vukit/kardtest/schematic/kardtest.pdf

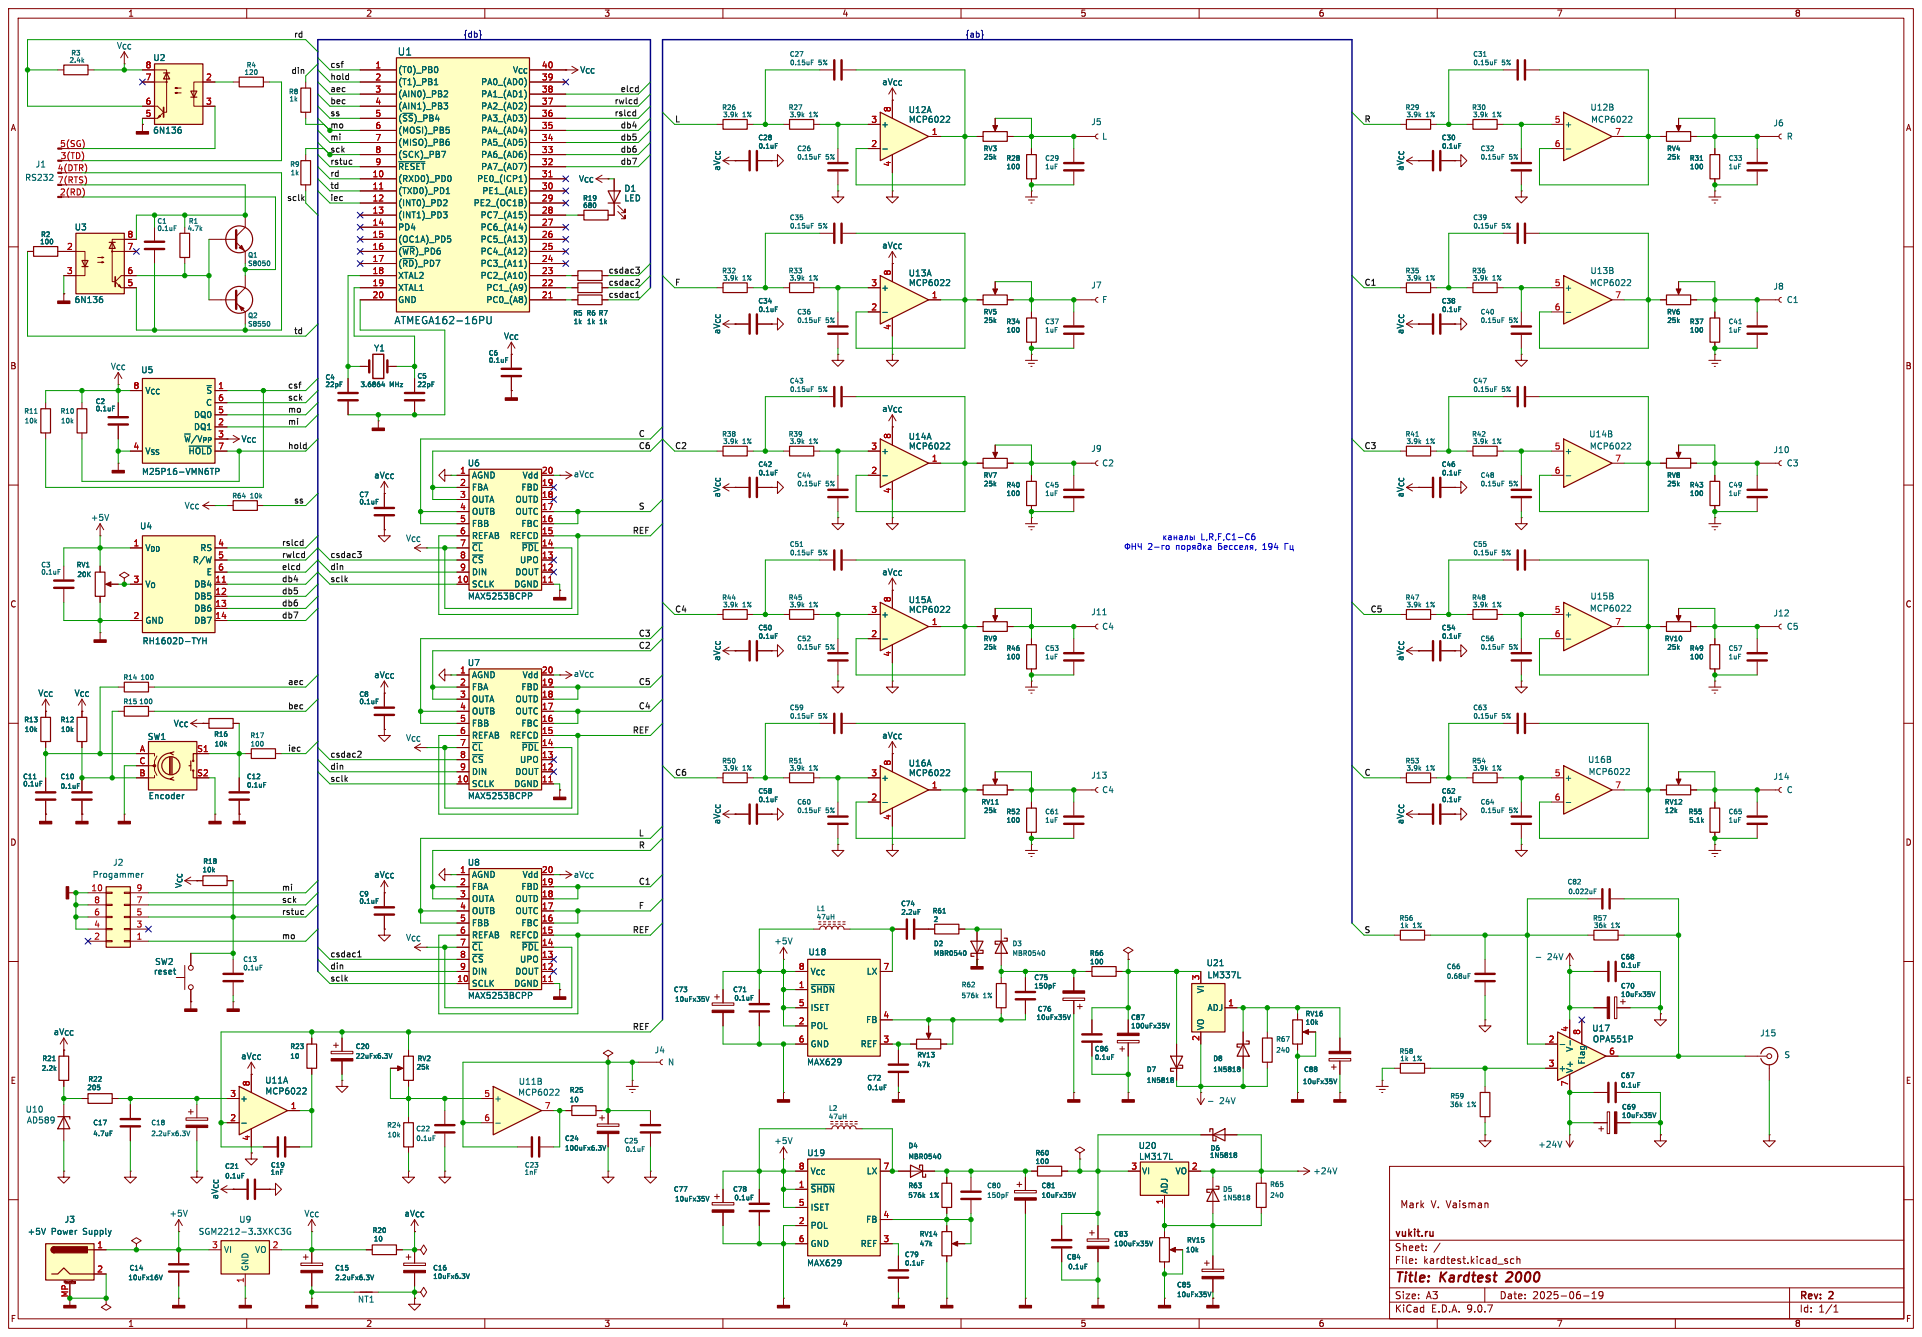
[picture p1: page 1]

mo mi csf bec hold

6 DQ0 5 DQ1 2 ~{W}/V_{PP} 3 ~{HOLD}7 V_{CC} 8 V_{SS} 4 U5M25P16-VMN6TP

6 DQ0 5 DQ1 2 ~{W}/V_{PP} 3 ~{HOLD}7 V_{CC} 8 V_{SS} 4 C2

csf hold mi sck elcdmo
