vukit/kardtest/schematic/kardtest.kicad_sch

## KiCad design schematic/kardtest.kicad_sch (2026-04-05)

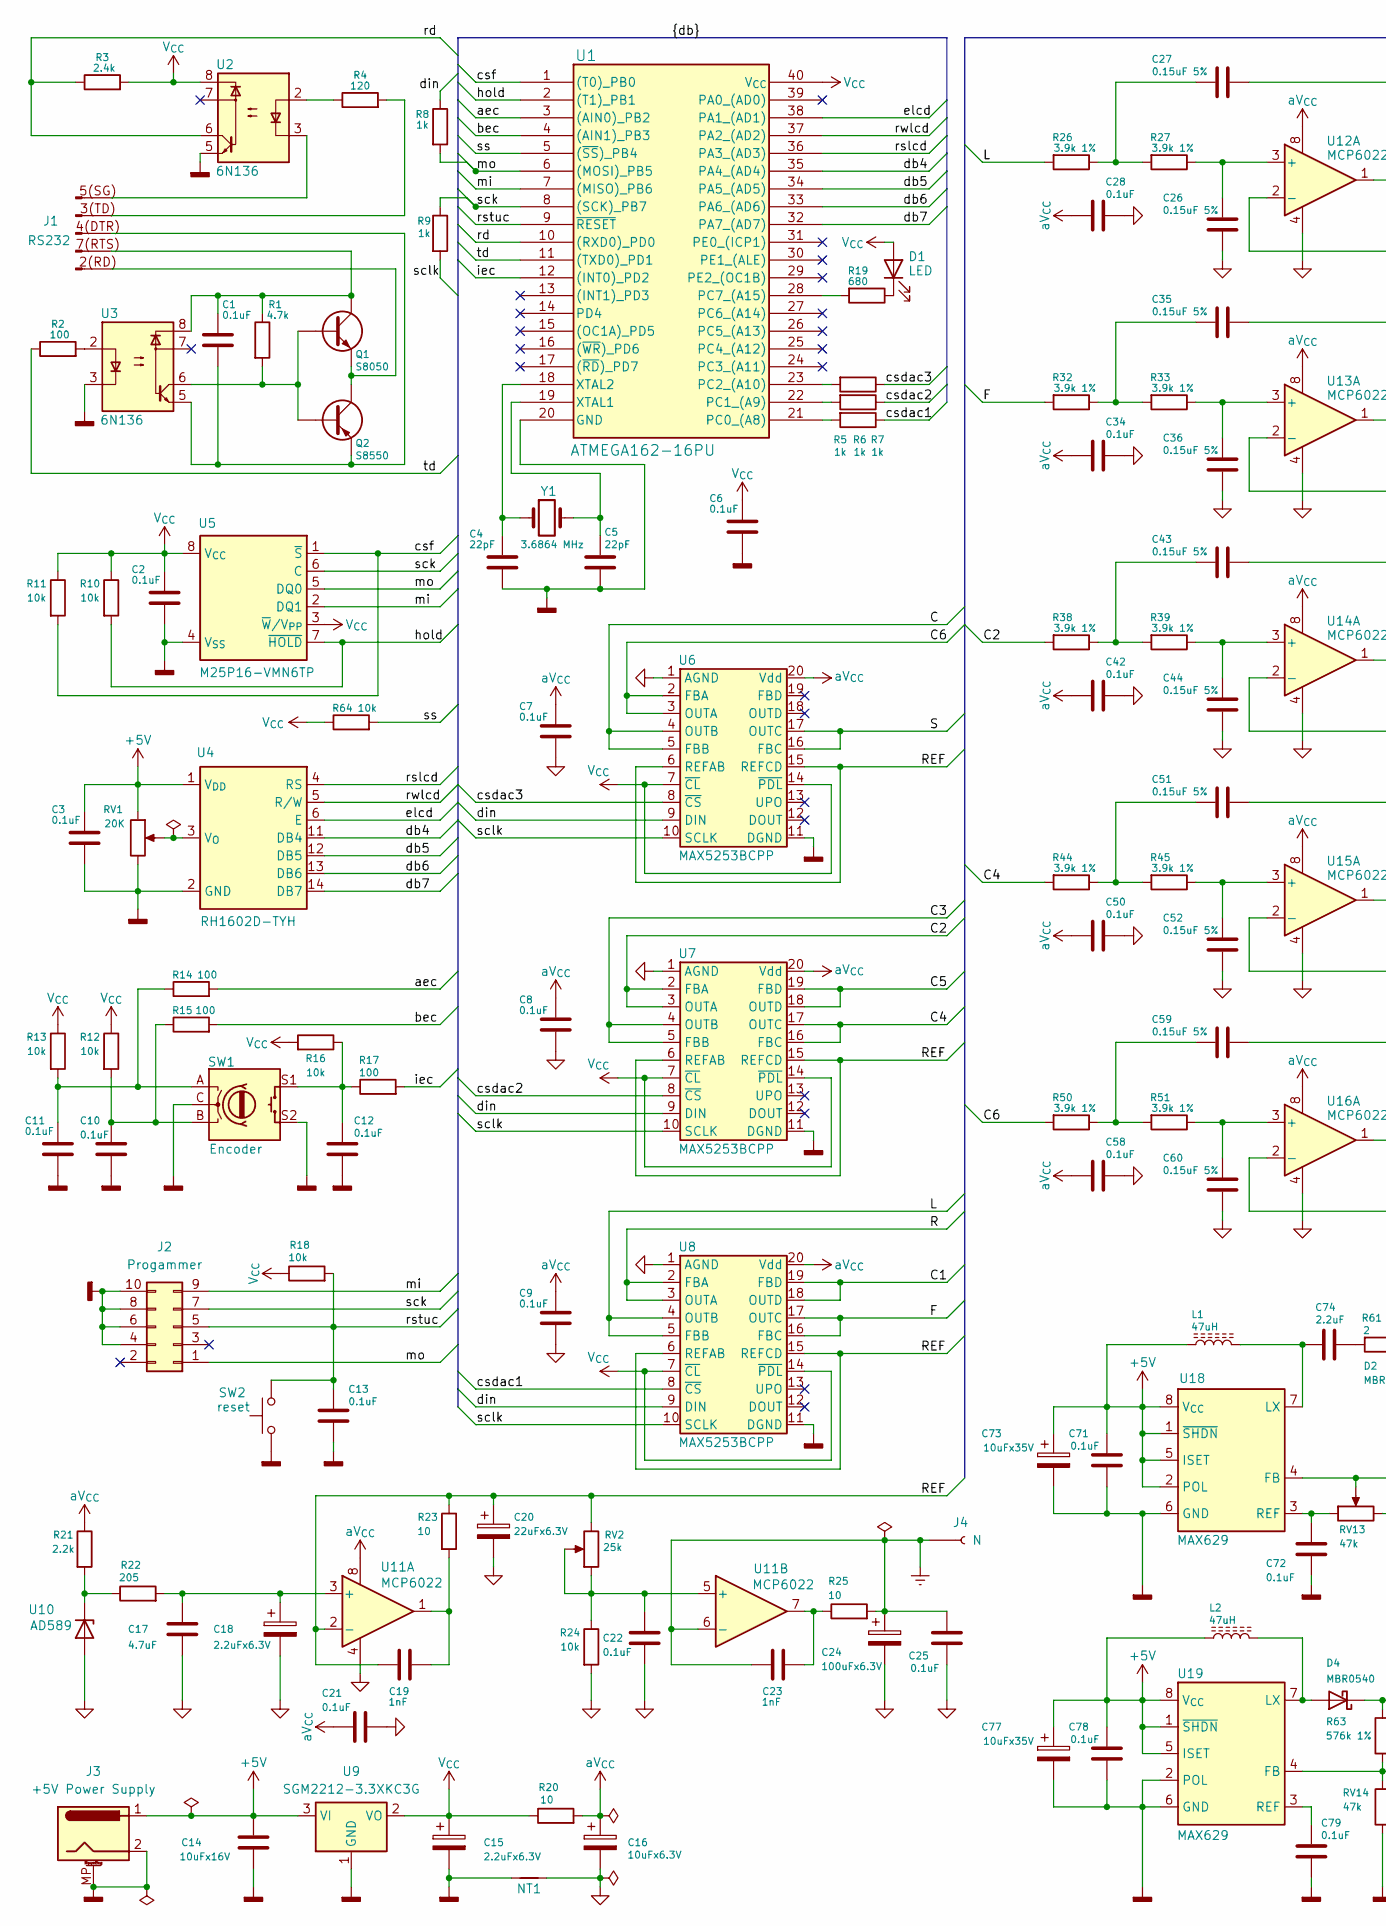
[picture p2: schematic kardtest.kicad_sch, part in row 1, column 1]

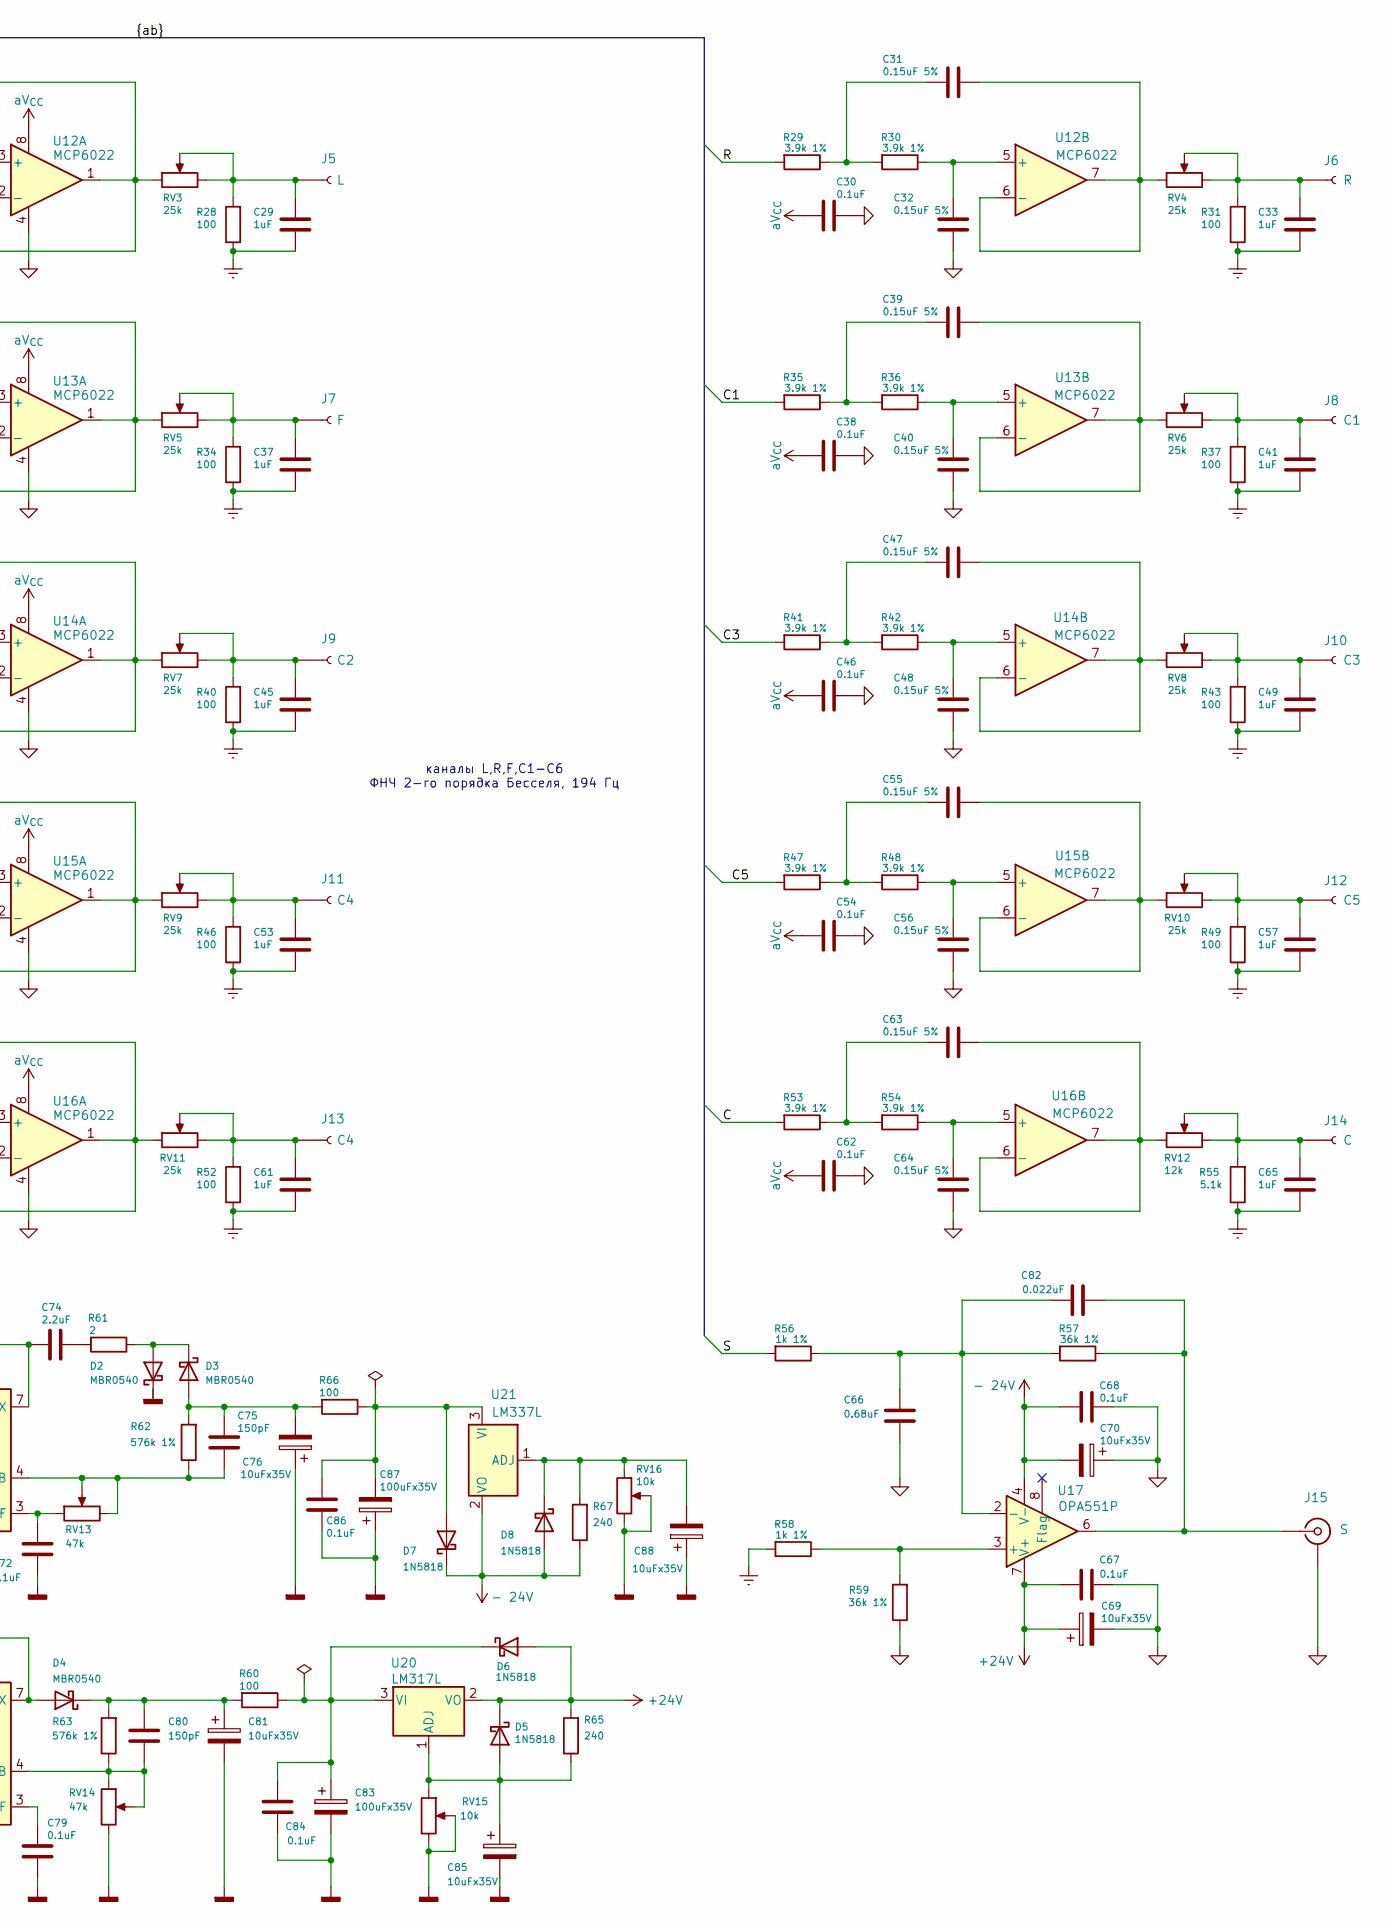
[picture p3: schematic kardtest.kicad_sch, part in row 1, column 2]

Parts:
C1, C2, C3, C6, C7, C8, C9, C10, C11, C12, C13, C21, C22, C25, C28, C30, C34, C38, C42, C46, C50, C54, C58, C62, C67, C68, C71, C72, C78, C79, C84, C86: 0.1uF
C4, C5: 22pF
C14: 10uFx16V
C15, C18: 2.2uFx6.3V
C16: 10uFx6.3V
C17: 4.7uF
C19, C23: 1nF
C20: 22uFx6.3V
C24: 100uFx6.3V
C26, C27, C31, C32, C35, C36, C39, C40, C43, C44, C47, C48, C51, C52, C55, C56, C59, C60, C63, C64: 0.15uF 5%
C29, C33, C37, C41, C45, C49, C53, C57, C61, C65: 1uF
C66: 0.68uF
C69, C70, C73, C76, C77, C81, C85, C88: 10uFx35V
C74: 2.2uF
C75, C80: 150pF
C82: 0.022uF
C83, C87: 100uFx35V
D1: LED
D2, D3, D4: MBR0540; D_SOD-123
D5, D6, D7, D8: 1N5818; D_DO-41_SOD81_P10.16mm_Horizontal
J1: RS232
J2: Progammer
J3: +5V Power Supply
J4: N
J5: L
J6: R
J7: F
J8: C1
J9: C2
J10: C3
J11, J13: C4
J12: C5
J14: C
J15: S
L1, L2: 47uH
NT1: NetTie_2
Q1: S8050; TO-92_Inline
Q2: S8550; TO-92_Inline
R1: 4.7k
R2, R14, R15, R17, R28, R31, R34, R37, R40, R43, R46, R49, R52, R60, R66: 100
R3: 2.4k
R4: 120
R5, R6, R7, R8, R9: 1k
R10, R11, R12, R13, R16, R18, R24, R64: 10k
R19: 680
R20, R23, R25: 10
R21: 2.2k
R22: 205
R26, R27, R29, R30, R32, R33, R35, R36, R38, R39, R41, R42, R44, R45, R47, R48, R50, R51, R53, R54: 3.9k 1%
R55: 5.1k
R56, R58: 1k 1%
R57, R59: 36k 1%
R61: 2
R62, R63: 576k 1%
R65, R67: 240
RV1: 20K
RV2, RV3, RV4, RV5, RV6, RV7, RV8, RV9, RV10, RV11: 25k
RV12: 12k
RV13, RV14: 47k
RV15, RV16: 10k
SW1: Encoder
SW2: reset
U1: ATMEGA162-16PU; DIP-40_W15.24mm
U2, U3: 6N136; DIP-8_W7.62mm
U4: RH1602D-TYH
U5: M25P16-VMN6TP
U6, U7, U8: MAX5253BCPP; DIP-20_W7.62mm
U9: SGM2212-3.3XKC3G; SOT-223-3_TabPin2
U10: AD589
U11, U12, U13, U14, U15, U16: MCP6022
U17: OPA551P; DIP-8_W7.62mm
U18, U19: MAX629
U20: LM317L; TO-92_Inline
U21: LM337L; TO-92_Inline
Y1: 3.6864 MHz

Connections:
+5V: C3.1, C14.1, C71.1, C73.1, C77.1, C78.1, J3.1, L1.1, L2.1, RV1.1, U4.1 (V_{DD}), U9.3 (VI), U18.1 (~SHDN), U18.2 (POL), U18.5 (ISET), U18.8 (V_{CC}), U19.1 (~SHDN), U19.5 (ISET), U19.8 (V_{CC})
+24V: C67.1, C69.1, D5.1 (K), D6.2 (A), R65.2, U17.7 (V+), U20.2 (VO)
- 24V: C68.1, C70.2, D7.1 (K), D8.2 (A), R67.1, U17.4 (V-), U21.2 (VO)
C: R53.2, U6.4 (OUTB), U6.5 (FBB)
C1: R35.2, U8.18 (OUTD), U8.19 (FBD)
C2: R38.2, U7.2 (FBA), U7.3 (OUTA)
C3: R41.2, U7.4 (OUTB), U7.5 (FBB)
C4: R44.2, U7.16 (FBC), U7.17 (OUTC)
C5: R47.2, U7.18 (OUTD), U7.19 (FBD)
C6: R50.2, U6.2 (FBA), U6.3 (OUTA)
F: R32.2, U8.16 (FBC), U8.17 (OUTC)
GNDA: C7.2, C8.2, C9.2, C16.2, C17.2, C18.2, C20.2, C21.1, C22.2, C24.2, C25.2, C26.2, C28.2, C30.2, C32.2, C34.2, C36.2, C38.2, C40.2, C42.2, C44.2, C46.2, C48.2, C50.2, C52.2, C54.2, C56.2, C58.2, C60.2, C62.2, C64.2, C66.2, C67.2, C68.2, C69.2, C70.1, J15.2 (Ext), NT1.2, R24.2, R59.1, U6.1 (AGND), U7.1 (AGND), U8.1 (AGND), U10.2 (A), U11.4 (V-), U12.4 (V-), U13.4 (V-), U14.4 (V-), U15.4 (V-), U16.4 (V-)
GNDD: C2.2, C3.2, C4.2, C5.2, C6.2, C10.2, C11.2, C12.2, C13.2, C14.2, C15.2, C71.2, C72.2, C73.2, C76.1, C77.2, C78.2, C79.2, C81.2, C83.2, C84.2, C85.2, C86.2, C87.1, C88.1, D2.1 (K), J2.4, J2.6, J2.8, J2.10, J3.2, J3.MP (MountPin), NT1.1, RV1.3, RV14.3, RV15.2, RV15.3, RV16.2, RV16.3, SW1.C, SW1.S2, SW2.1, U1.20 (GND), U2.5, U3.3, U4.2 (GND), U5.4 (V_{SS}), U6.11 (DGND), U7.11 (DGND), U8.11 (DGND), U9.1 (GND), U18.6 (GND), U19.2 (POL), U19.6 (GND)
GNDV: C23.1, C24.1, C25.1, C29.2, C33.2, C37.2, C41.2, C45.2, C49.2, C53.2, C57.2, C61.2, C65.2, J4.1, R25.2, R28.1, R31.1, R34.1, R37.1, R40.1, R43.1, R46.1, R49.1, R52.1, R55.1, R58.2, U11.6 (-)
L: R26.2, U8.4 (OUTB), U8.5 (FBB)
unnamed: C1.1, J1.7(RTS) (Pin_7), Q1.3 (C), R1.1, U3.8
unnamed: C1.2, J1.4(DTR) (Pin_4), Q2.1 (E), U3.5
unnamed: C4.1, U1.18 (XTAL2), Y1.1
unnamed: C5.1, U1.19 (XTAL1), Y1.2
unnamed: C10.1, R12.2, R15.1, SW1.B
unnamed: C11.1, R13.2, R14.1, SW1.A
unnamed: C12.1, R16.1, R17.1, SW1.S1
unnamed: C17.1, C18.1, R22.2, U11.3 (+)
unnamed: C19.2, R23.2, U11.1
unnamed: C22.1, R24.1, RV2.1, RV2.2, U11.5 (+)
unnamed: C23.2, R25.1, U11.7
unnamed: C26.1, R27.1, U12.3 (+)
unnamed: C27.1, R26.1, R27.2
unnamed: C27.2, RV3.1, U12.1, U12.2 (-)
unnamed: C29.1, J5.1, R28.2, RV3.2, RV3.3
unnamed: C31.1, R29.1, R30.2
unnamed: C31.2, RV4.1, U12.6 (-), U12.7
unnamed: C32.1, R30.1, U12.5 (+)
unnamed: C33.1, J6.1, R31.2, RV4.2, RV4.3
unnamed: C35.1, R32.1, R33.2
unnamed: C35.2, RV5.1, U13.1, U13.2 (-)
unnamed: C36.1, R33.1, U13.3 (+)
unnamed: C37.1, J7.1, R34.2, RV5.2, RV5.3
unnamed: C39.1, R35.1, R36.2
unnamed: C39.2, RV6.1, U13.6 (-), U13.7
unnamed: C40.1, R36.1, U13.5 (+)
unnamed: C41.1, J8.1, R37.2, RV6.2, RV6.3
unnamed: C43.1, R38.1, R39.2
unnamed: C43.2, RV7.1, U14.1, U14.2 (-)
unnamed: C44.1, R39.1, U14.3 (+)
unnamed: C45.1, J9.1, R40.2, RV7.2, RV7.3
unnamed: C47.1, R41.1, R42.2
unnamed: C47.2, RV8.1, U14.6 (-), U14.7
unnamed: C48.1, R42.1, U14.5 (+)
unnamed: C49.1, J10.1, R43.2, RV8.2, RV8.3
unnamed: C51.1, R44.1, R45.2
unnamed: C51.2, RV9.1, U15.1, U15.2 (-)
unnamed: C52.1, R45.1, U15.3 (+)
unnamed: C53.1, J11.1, R46.2, RV9.2, RV9.3
unnamed: C55.1, R47.1, R48.2
unnamed: C55.2, RV10.1, U15.6 (-), U15.7
unnamed: C56.1, R48.1, U15.5 (+)
unnamed: C57.1, J12.1, R49.2, RV10.2, RV10.3
unnamed: C59.1, R50.1, R51.2
unnamed: C59.2, RV11.1, U16.1, U16.2 (-)
unnamed: C60.1, R51.1, U16.3 (+)
unnamed: C61.1, J13.1, R52.2, RV11.2, RV11.3
unnamed: C63.1, R53.1, R54.2
unnamed: C63.2, RV12.1, U16.6 (-), U16.7
unnamed: C64.1, R54.1, U16.5 (+)
unnamed: C65.1, J14.1, R55.2, RV12.2, RV12.3
unnamed: C66.1, C82.1, R56.1, R57.2, U17.2 (-)
unnamed: C72.1, RV13.1, U18.3 (REF)
unnamed: C74.1, L1.2, U18.7 (LX)
unnamed: C74.2, R61.2
unnamed: C75.1, C76.2, D3.2 (A), R62.2, R66.2
unnamed: C75.2, R62.1, RV13.2, RV13.3, U18.4 (FB)
unnamed: C79.1, U19.3 (REF)
unnamed: C80.1, C81.1, D4.1 (K), R60.2, R63.2
unnamed: C80.2, R63.1, RV14.1, RV14.2, U19.4 (FB)
unnamed: C82.2, J15.1 (In), R57.1, U17.6
unnamed: C83.1, C84.1, D6.1 (K), R60.1, U20.3 (VI)
unnamed: C85.1, D5.2 (A), R65.1, RV15.1, U20.1 (ADJ)
unnamed: C86.1, C87.2, D7.2 (A), R66.1, U21.3 (VI)
unnamed: C88.2, D8.1 (K), R67.2, RV16.1, U21.1 (ADJ)
unnamed: D1.1 (K), R19.1
unnamed: D2.2 (A), D3.1 (K), R61.1
unnamed: D4.2 (A), L2.2, U19.7 (LX)
unnamed: J1.2(RD) (Pin_2), Q1.1 (E), Q2.3 (C)
unnamed: J1.3(TD) (Pin_3), R4.2
unnamed: J1.5(SG) (Pin_5), U2.3
unnamed: Q1.2 (B), Q2.2 (B), R1.2, U3.6
unnamed: R2.2, U3.2
unnamed: R4.1, U2.2
unnamed: R5.2, U1.23 (PC2_(A10))
unnamed: R6.2, U1.22 (PC1_(A9))
unnamed: R7.2, U1.21 (PC0_(A8))
unnamed: R19.2, U1.28 (PC7_(A15))
unnamed: R21.2, R22.1, U10.1 (K)
unnamed: R58.1, R59.2, U17.3 (+)
unnamed: RV1.2, U4.3 (V_{O})
R: R29.2, U8.2 (FBA), U8.3 (OUTA)
REF: C19.1, C20.1, R23.1, RV2.3, U6.6 (REFAB), U6.15 (REFCD), U7.6 (REFAB), U7.15 (REFCD), U8.6 (REFAB), U8.15 (REFCD), U11.2 (-)
S: R56.2, U6.16 (FBC), U6.17 (OUTC)
V_{CC}: C2.1, C6.1, C15.1, D1.2 (A), R3.2, R10.1, R11.1, R12.1, R13.1, R16.2, R18.1, R20.1, R64.1, U1.40 (V_{CC}), U2.8, U5.3 (~W/V_{PP}), U5.8 (V_{CC}), U6.7 (~CL), U6.14 (~PDL), U7.7 (~CL), U7.14 (~PDL), U8.7 (~CL), U8.14 (~PDL), U9.2 (VO)
aV_{CC}: C7.1, C8.1, C9.1, C16.1, C21.2, C28.1, C30.1, C34.1, C38.1, C42.1, C46.1, C50.1, C54.1, C58.1, C62.1, R20.2, R21.1, U6.20 (Vdd), U7.20 (Vdd), U8.20 (Vdd), U11.8 (V+), U12.8 (V+), U13.8 (V+), U14.8 (V+), U15.8 (V+), U16.8 (V+)
aec: R14.2, U1.3 ((AIN0)_PB2)
bec: R15.2, U1.4 ((AIN1)_PB3)
csdac1: R7.1, U8.8 (~CS)
csdac2: R6.1, U7.8 (~CS)
csdac3: R5.1, U6.8 (~CS)
csf: R11.2, U1.1 ((T0)_PB0), U5.1 (~S)
db4: U1.35 (PA4_(AD4)), U4.11 (DB4)
db5: U1.34 (PA5_(AD5)), U4.12 (DB5)
db6: U1.33 (PA6_(AD6)), U4.13 (DB6)
db7: U1.32 (PA7_(AD7)), U4.14 (DB7)
din: R8.1, U6.9 (DIN), U7.9 (DIN), U8.9 (DIN)
elcd: U1.38 (PA1_(AD1)), U4.6 (E)
hold: R10.2, U1.2 ((T1)_PB1), U5.7 (~HOLD)
iec: R17.2, U1.12 ((INT0)_PD2)
mi: J2.9, U1.7 ((MISO)_PB6), U5.2 (DQ1)
mo: J2.1, R8.2, U1.6 ((MOSI)_PB5), U5.5 (DQ0)
rd: R3.1, U1.10 ((RXD0)_PD0), U2.6
rslcd: U1.36 (PA3_(AD3)), U4.4 (RS)
rstuc: C13.1, J2.5, R18.2, SW2.2, U1.9 (~RESET)
rwlcd: U1.37 (PA2_(AD2)), U4.5 (R/W)
sck: J2.7, R9.1, U1.8 ((SCK)_PB7), U5.6 (C)
sclk: R9.2, U6.10 (SCLK), U7.10 (SCLK), U8.10 (SCLK)
ss: R64.2, U1.5 ((~SS)_PB4)
td: R2.1, U1.11 ((TXD0)_PD1)

Notes on the sheet:
каналы L,R,F,C1-C6 ФНЧ 2-го порядка Бесселя, 194 Гц
