vukit/kardtest/firmware/lcd/lcd_definitions.h

/*************************************************************************
Title:    Kardtest lcd/lcd_definitions.h
Author:   Mark Vaisman  <mark.v.vaisman@gmail.com>  https://vukit.ru/articles/ecs-simulator/
Software: AVR-GCC 5.4.x
License:  MIT License
**************************************************************************/
#define LCD_LINES 2
#define LCD_IO_MODE 1
#define LCD_PORT PORTA
#define LCD_DATA0_PORT LCD_PORT
#define LCD_DATA1_PORT LCD_PORT
#define LCD_DATA2_PORT LCD_PORT
#define LCD_DATA3_PORT LCD_PORT
#define LCD_DATA0_PIN 4
#define LCD_DATA1_PIN 5
#define LCD_DATA2_PIN 6
#define LCD_DATA3_PIN 7
#define LCD_RS_PORT LCD_PORT
#define LCD_RS_PIN 3
#define LCD_RW_PORT LCD_PORT
#define LCD_RW_PIN 2
#define LCD_E_PORT LCD_PORT
#define LCD_E_PIN 1
