vukit/kardtest/firmware/tasks/names.h

/*************************************************************************
Title:    Kardtest tasks/names.h
Author:   Mark Vaisman  <mark.v.vaisman@gmail.com>  https://vukit.ru/articles/ecs-simulator/
Software: AVR-GCC 5.4.x
License:  MIT License
**************************************************************************/
#include <avr/pgmspace.h>

extern const char task_0_name[] PROGMEM;
extern const char task_1_name[] PROGMEM;
extern const char task_2_name[] PROGMEM;
extern const char task_3_name[] PROGMEM;

extern PGM_P const task_names[] PROGMEM;
